CircuitMonkey/mnemosyne/Documents/photos/mnemosyne-pcbs - 1.jpeg

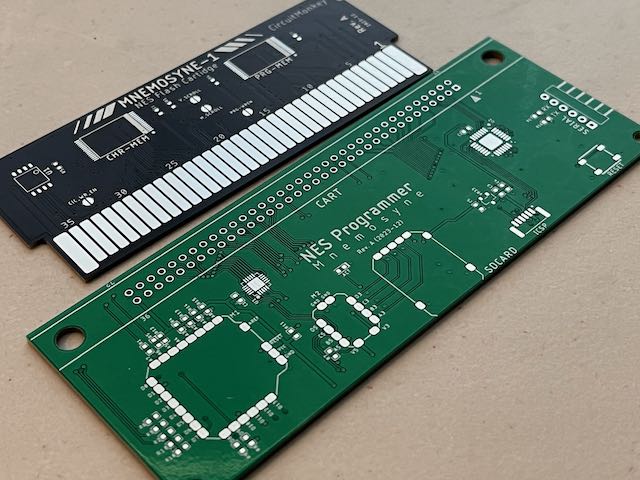
Documents/photos/mnemosyne-pcbs - 1.jpeg
