CircuitMonkey/mnemosyne/README.md

# mnemosyne
Flash based NES Cartridge and programmer. Experimental project.
