CircuitMonkey/mnemosyne/Documents/nes-cartridge-bom.ods

NES Cartridge |  |  | Rev. A (2023-12)
Part | Value | Device | Package | Description | COST01 | COST10 | COST100 | MFR | MPN
PCB1 | NES Min Size | NES-CARTRIDGE-MAX | NES-1-MIN | NES Cartridge
R1 | 10K | RESISTOR0603 | 0603-RES | Resistor | 0.1 | 0.05 | 0.02
R4 | 10K | RESISTOR0603 | 0603-RES | Resistor | 0.1 | 0.05 | 0.02
R5 | 10K | RESISTOR0603 | 0603-RES | Resistor | 0.1 | 0.05 | 0.02
C1 | 0.1uF | CAPACITOR0603 | 0603-CAP | Capacitor | 0.12 | 0.09 | 0.05
C2 | 0.1uF | CAPACITOR0603 | 0603-CAP | Capacitor | 0.12 | 0.09 | 0.05
U1 | ATtiny13A | ATTINY13A-SO8 | SOIC-8S2 | ATmega 13A microcontroller | 1.1 | 1 | 0.8 | Microchip | ATTINY13A-S
CHR-MEM | FLASH 512K x 8 | FLASH_512KX8-512K-TSOP | TSOP32-14X8MM | Flash - 8 bit parallel, up to 512Kx8 | 2.3 | 2.1 | 1.8 | Microchip | SST39SF040-70-4C-Wxx
PRG-MEM | FLASH 512K x 8 | FLASH_512KX8-512K-TSOP | TSOP32-14X8MM | Flash - 8 bit parallel, up to 512Kx8 | 2.3 | 2.1 | 1.8 | Microchip | SST39SF040-70-4C-Wxx
