CircuitMonkey/mnemosyne/Documents/nes-programmer-1-bom.ods

Mnemosyne NES Programmer |  |  | Rev. A (2023-12)
Part | Value | Device | Package | Description | COST01 | COST10 | COST100 | MFR | MPN | MPN2 | MPN3 | SEEED | VALUE
PCB | PCB |  |  | PCB for programmer | $10.00 | $7.00 | $1.00
R1 | 4.7K | RESISTOR0603 | 0603-RES | Resistor | $0.10 | $0.05 | $0.02
R2 | 330 | RESISTOR0603 | 0603-RES | Resistor | $0.10 | $0.05 | $0.02
R3 | 330 | RESISTOR0603 | 0603-RES | Resistor | $0.10 | $0.05 | $0.02
R4 | 4.7K | RESISTOR0603 | 0603-RES | Resistor | $0.10 | $0.05 | $0.02
R5 | 330 | RESISTOR0603 | 0603-RES | Resistor | $0.10 | $0.05 | $0.02
R6 | 330 | RESISTOR0603 | 0603-RES | Resistor | $0.10 | $0.05 | $0.02
R7 | 10K | RESISTOR0603 | 0603-RES | Resistor | $0.10 | $0.05 | $0.02
R8 | 10K | RESISTOR0603 | 0603-RES | Resistor | $0.10 | $0.05 | $0.02
R9 | 10K | RESISTOR0603 | 0603-RES | Resistor | $0.10 | $0.05 | $0.02
R10 | 10K | RESISTOR0603 | 0603-RES | Resistor | $0.10 | $0.05 | $0.02
R11 | 10K | RESISTOR0603 | 0603-RES | Resistor | $0.10 | $0.05 | $0.02
R12 | 10K | RESISTOR0603 | 0603-RES | Resistor | $0.10 | $0.05 | $0.02
R13 | 4.7K | RESISTOR0603 | 0603-RES | Resistor | $0.10 | $0.05 | $0.02
R14 | 4.7K | RESISTOR0603 | 0603-RES | Resistor | $0.10 | $0.05 | $0.02
R15 | 4.7K | RESISTOR0603 | 0603-RES | Resistor | $0.10 | $0.05 | $0.02
R16 | 330 | RESISTOR0603 | 0603-RES | Resistor | $0.10 | $0.05 | $0.02
R17 | 330 | RESISTOR0603 | 0603-RES | Resistor | $0.10 | $0.05 | $0.02
R18 | 2K | RESISTOR0603 | 0603-RES | Resistor | $0.10 | $0.05 | $0.02
C1 | 0.1uF | CAPACITOR0603 | 0603-CAP | Capacitor | $0.12 | $0.09 | $0.05
C2 | 0.1uF | CAPACITOR0603 | 0603-CAP | Capacitor | $0.12 | $0.09 | $0.05
C3 | 0.1uF | CAPACITOR0603 | 0603-CAP | Capacitor | $0.12 | $0.09 | $0.05
C4 | 10uF | CAPACITOR0603 | 0603-CAP | Capacitor | $0.12 | $0.09 | $0.05
C5 | 10uF | CAPACITOR0603 | 0603-CAP | Capacitor | $0.12 | $0.09 | $0.05
ACT | RED | SMT0603 | SMD_0603 | LED SMT | $0.20 | $0.17 | $0.14
U1 | MCP23S08 | MCP23S08-QFN | QFN-20 | Microchip 8-bit SPI I/O Expander | $1.65 | $1.65 | $1.32 | Microchip | MCP23S08-E/ML |  |  |  | MCP23S08
U2 | MCP23S17 | MCP23S17-QFN | QFN-28-6X6 | 16-Bit I/O Expander with SPI | $2.20 | $2.10 | $1.70 | Microchip | MCP23S17-x/ML |  |  |  | MCP23S17
VR33 | 3.3V | LDO-3P--3.3V-SOT23 | SOT-23 | regulator 3-pin | $0.76 | $0.66 | $0.55 |  | AP2120N-3.3 | XC6206P332MR-G | AP7387-33SA | 310030099 | 3.3V
M1 | ATmega328P Module | 0119REV-A | 0119A | ATmega328P Module | $18.38 | $13.22 | $9.09 | Circuit Monkey | 0119A |  |  |  | ATmega328P Module
M2 | 0124A | 0124REV-A | 0124A | Logic Level Translator | $5.17 | $3.60 | $1.86 | Circuit Monkey | 0124A |  |  |  | 0124A
SDCARD | 0127A | 0127REV-A | 0127A | SD Card Micro | $8.23 | $5.24 | $4.02 | Circuit Monkey | 0127A
RESET | Push Switch | PUSHBTN-MOMB3SN | B3SN | Pushbutton Switch | $1.05 | $0.95 | $0.75 | Omron | B3SN |  |  |  | Push Switch
CART | NES Cart Slot | NES-RECEPTACLE-VT-THD | NES-CONNECTOR | Receptacle for NES cartridge | $4.00 | $2.80 | $2.50 | AliExpress | not defined |  |  |  | NES Cart Slot, 72P, VT, THD
SERIAL | Molex 22-28-8062 | CON_06X1-RA | MA06X1-RA-THD | Header, 6-pin, single row | $0.30 | $0.20 | $0.10 |  |  |  |  |  | Molex 22-28-8062
ICSP | Connector, 6P, SM, VT | 06P-SM-VT-SMT | BM06B-SRSS-TB | Connector, 6P | $0.60 | $0.52 | $0.49 | JST | BM06-SRSS-TB |  |  |  | Connector, 6P, SM, VT
