CircuitMonkey/mnemosyne/PCB/nes-programmer-1.brd

## EAGLE design PCB/nes-programmer-1.brd (2024-01-12)

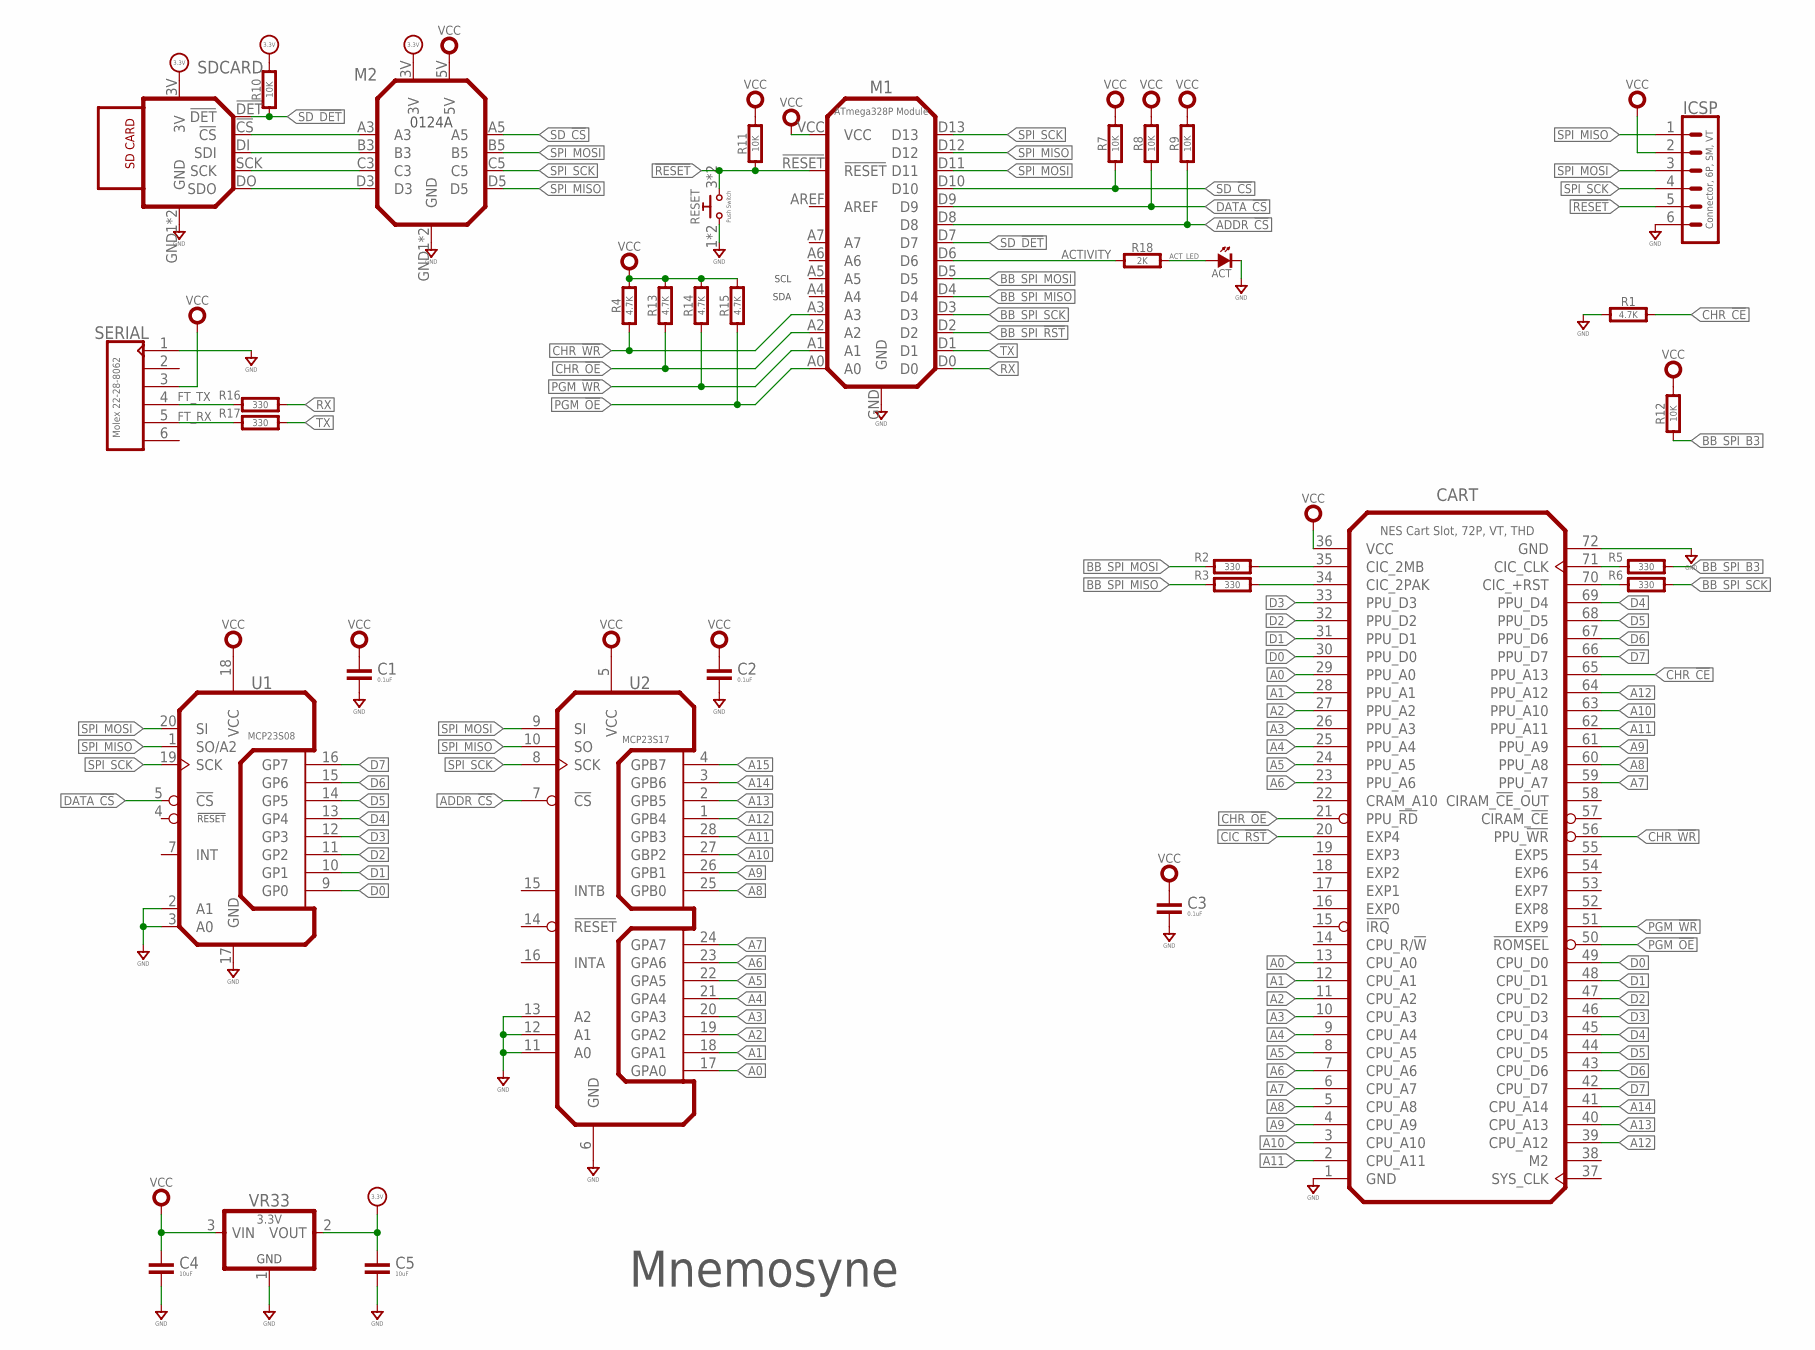
[picture p2: schematic nes-programmer-1.sch]

Parts:
ACT: SMT0603; SMD_0603
C1, C2, C3: 0.1uF; 0603-CAP
C4, C5: 10uF; 0603-CAP
CART: NES Cart Slot, 72P, VT, THD; NES-CONNECTOR-VT-THD
ICSP: Connector, 6P, SM, VT; BM06B-SRSS-TB
M1: ATmega328P Module; 0119A
M2: 0124A
R1, R4, R13, R14, R15: 4.7K; 0603-RES
R2, R3, R5, R6, R16, R17: 330; 0603-RES
R7, R8, R9, R10, R11, R12: 10K; 0603-RES
R18: 2K; 0603-RES
RESET: Push Switch; B3SN
SDCARD: 0127REV-A; 0127A
SERIAL: Molex 22-28-8062; MA06X1-RA-THD
U1: MCP23S08; QFN-20
U2: MCP23S17; QFN-28-6X6
VR33: 3.3V; SOT-23

Connections:
!RESET: ICSP.5, M1.!RESET, R11.1, RESET.3 (2), RESET.4 (2)
+3.3V: C5.1, M2.3V, R10.2, SDCARD.3V, VR33.2 (VOUT)
A0: CART.13 (CPU_A0), CART.29 (PPU_A0), U2.17 (GPA0)
A1: CART.12 (CPU_A1), CART.28 (PPU_A1), U2.18 (GPA1)
A2: CART.11 (CPU_A2), CART.27 (PPU_A2), U2.19 (GPA2)
A3: CART.10 (CPU_A3), CART.26 (PPU_A3), U2.20 (GPA3)
A4: CART.9 (CPU_A4), CART.25 (PPU_A4), U2.21 (GPA4)
A5: CART.8 (CPU_A5), CART.24 (PPU_A5), U2.22 (GPA5)
A6: CART.7 (CPU_A6), CART.23 (PPU_A6), U2.23 (GPA6)
A7: CART.6 (CPU_A7), CART.59 (PPU_A7), U2.24 (GPA7)
A8: CART.5 (CPU_A8), CART.60 (PPU_A8), U2.25 (GPB0)
A9: CART.4 (CPU_A9), CART.61 (PPU_A9), U2.26 (GPB1)
A10: CART.3 (CPU_A10), CART.63 (PPU_A10), U2.27 (GBP2)
A11: CART.2 (CPU_A11), CART.62 (PPU_A11), U2.28 (GPB3)
A12: CART.39 (CPU_A12), CART.64 (PPU_A12), U2.1 (GPB4)
A13: CART.40 (CPU_A13), U2.2 (GPB5)
A14: CART.41 (CPU_A14), U2.3 (GPB6)
A15: U2.4 (GPB7)
ACTIVITY: M1.D6, R18.1
ACT_LED: ACT.A, R18.2
ADDR_!CS: M1.D8, R9.1, U2.7 (!CS)
BB_SPI_!RST: M1.D2
BB_SPI_B3: R5.2, R12.1
BB_SPI_MISO: M1.D4, R3.1
BB_SPI_MOSI: M1.D5, R2.1
BB_SPI_SCK: M1.D3, R6.2
CHR_!CE: CART.65 (PPU_A13), R1.2
CHR_!OE: CART.21 (PPU_!RD), M1.A2, R13.1
CHR_!WR: CART.56 (PPU_!WR), M1.A3, R4.1
CIC_2MB: CART.35 (CIC_2MB), R2.2
CIC_2PAK: CART.34 (CIC_2PAK), R3.2
CIC_!RST: CART.20 (EXP4)
CIC_+RST: CART.70 (CIC_+RST), R6.1
CIC_CLK: CART.71 (CIC_CLK), R5.1
D0: CART.30 (PPU_D0), CART.49 (CPU_D0), U1.9 (GP0)
D1: CART.31 (PPU_D1), CART.48 (CPU_D1), U1.10 (GP1)
D2: CART.32 (PPU_D2), CART.47 (CPU_D2), U1.11 (GP2)
D3: CART.33 (PPU_D3), CART.46 (CPU_D3), U1.12 (GP3)
D4: CART.45 (CPU_D4), CART.69 (PPU_D4), U1.13 (GP4)
D5: CART.44 (CPU_D5), CART.68 (PPU_D5), U1.14 (GP5)
D6: CART.43 (CPU_D6), CART.67 (PPU_D6), U1.15 (GP6)
D7: CART.42 (CPU_D7), CART.66 (PPU_D7), U1.16 (GP7)
DATA_!CS: M1.D9, R8.1, U1.5 (!CS)
FT_RX: R17.1, SERIAL.5
FT_TX: R16.1, SERIAL.4
GND: ACT.K (C), C1.2, C2.2, C3.2, C4.2, C5.2, CART.1 (GND), CART.72 (GND), ICSP.6, M1.GND, M2.GND1 (GND), M2.GND2 (GND), R1.1, RESET.1, RESET.2 (1), SDCARD.GND1 (GND), SDCARD.GND2 (GND), SERIAL.1, U1.2 (A1), U1.3 (A0), U1.17 (GND), U2.6 (GND), U2.11 (A0), U2.12 (A1), U2.13 (A2), VR33.1 (GND)
unnamed: M2.D3, SDCARD.DO (SDO)
unnamed: M2.C3, SDCARD.SCK
unnamed: M2.B3, SDCARD.DI (SDI)
unnamed: M2.A3, SDCARD.!CS
PGM_!OE: CART.50 (!ROMSEL), M1.A0, R15.1
PGM_!WR: CART.51 (EXP9), M1.A1, R14.1
RX: M1.D0, R16.2
SD_!CS: M1.D10, M2.A5, R7.1
SD_!DET: M1.D7, R10.1, SDCARD.!DET
SPI_MISO: ICSP.1, M1.D12, M2.D5, U1.1 (SO/A2), U2.10 (SO)
SPI_MOSI: ICSP.3, M1.D11, M2.B5, U1.20 (SI), U2.9 (SI)
SPI_SCK: ICSP.4, M1.D13, M2.C5, U1.19 (SCK), U2.8 (SCK)
TX: M1.D1, R17.2
VCC: C1.1, C2.1, C3.1, C4.1, CART.36 (VCC), ICSP.2, M1.VCC, M2.5V, R4.2, R7.2, R8.2, R9.2, R11.2, R12.2, R13.2, R14.2, R15.2, SERIAL.3, U1.18 (VCC), U2.5 (VCC), VR33.3 (VIN)

Notes on the sheet:
SDA
SCL
Mnemosyne

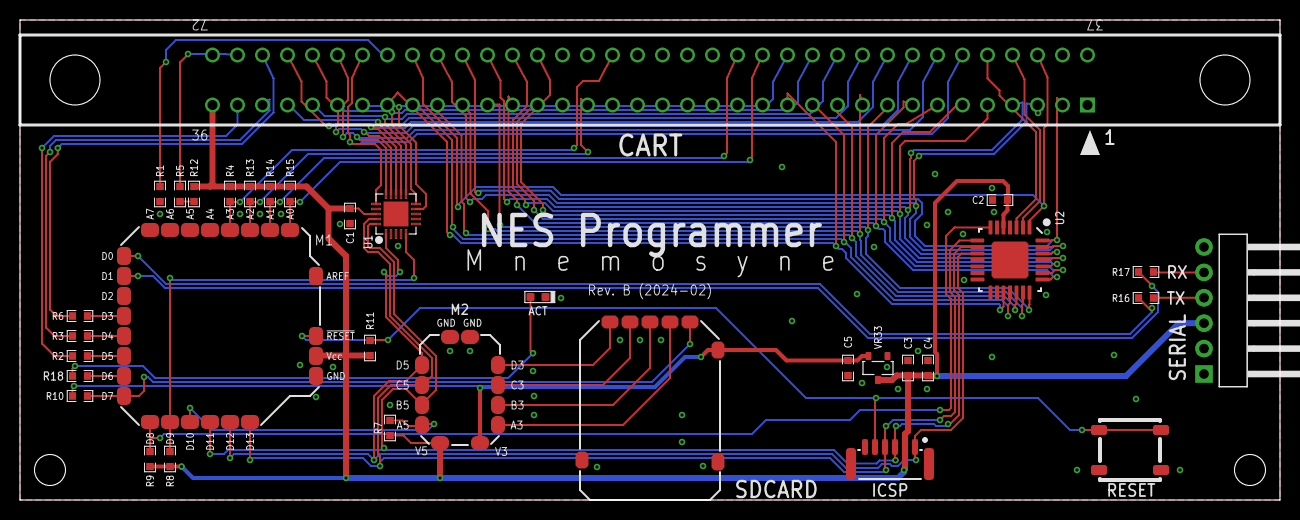
[picture p3: board nes-programmer-1.brd from above]

Board: 2 copper layers, 126.0 x 48.0 mm, 34 parts (0 on the bottom side), 57 nets.
