CircuitMonkey/mnemosyne/PCB/nes-cartridge.brd

## EAGLE design PCB/nes-cartridge.brd (2023-12-23)

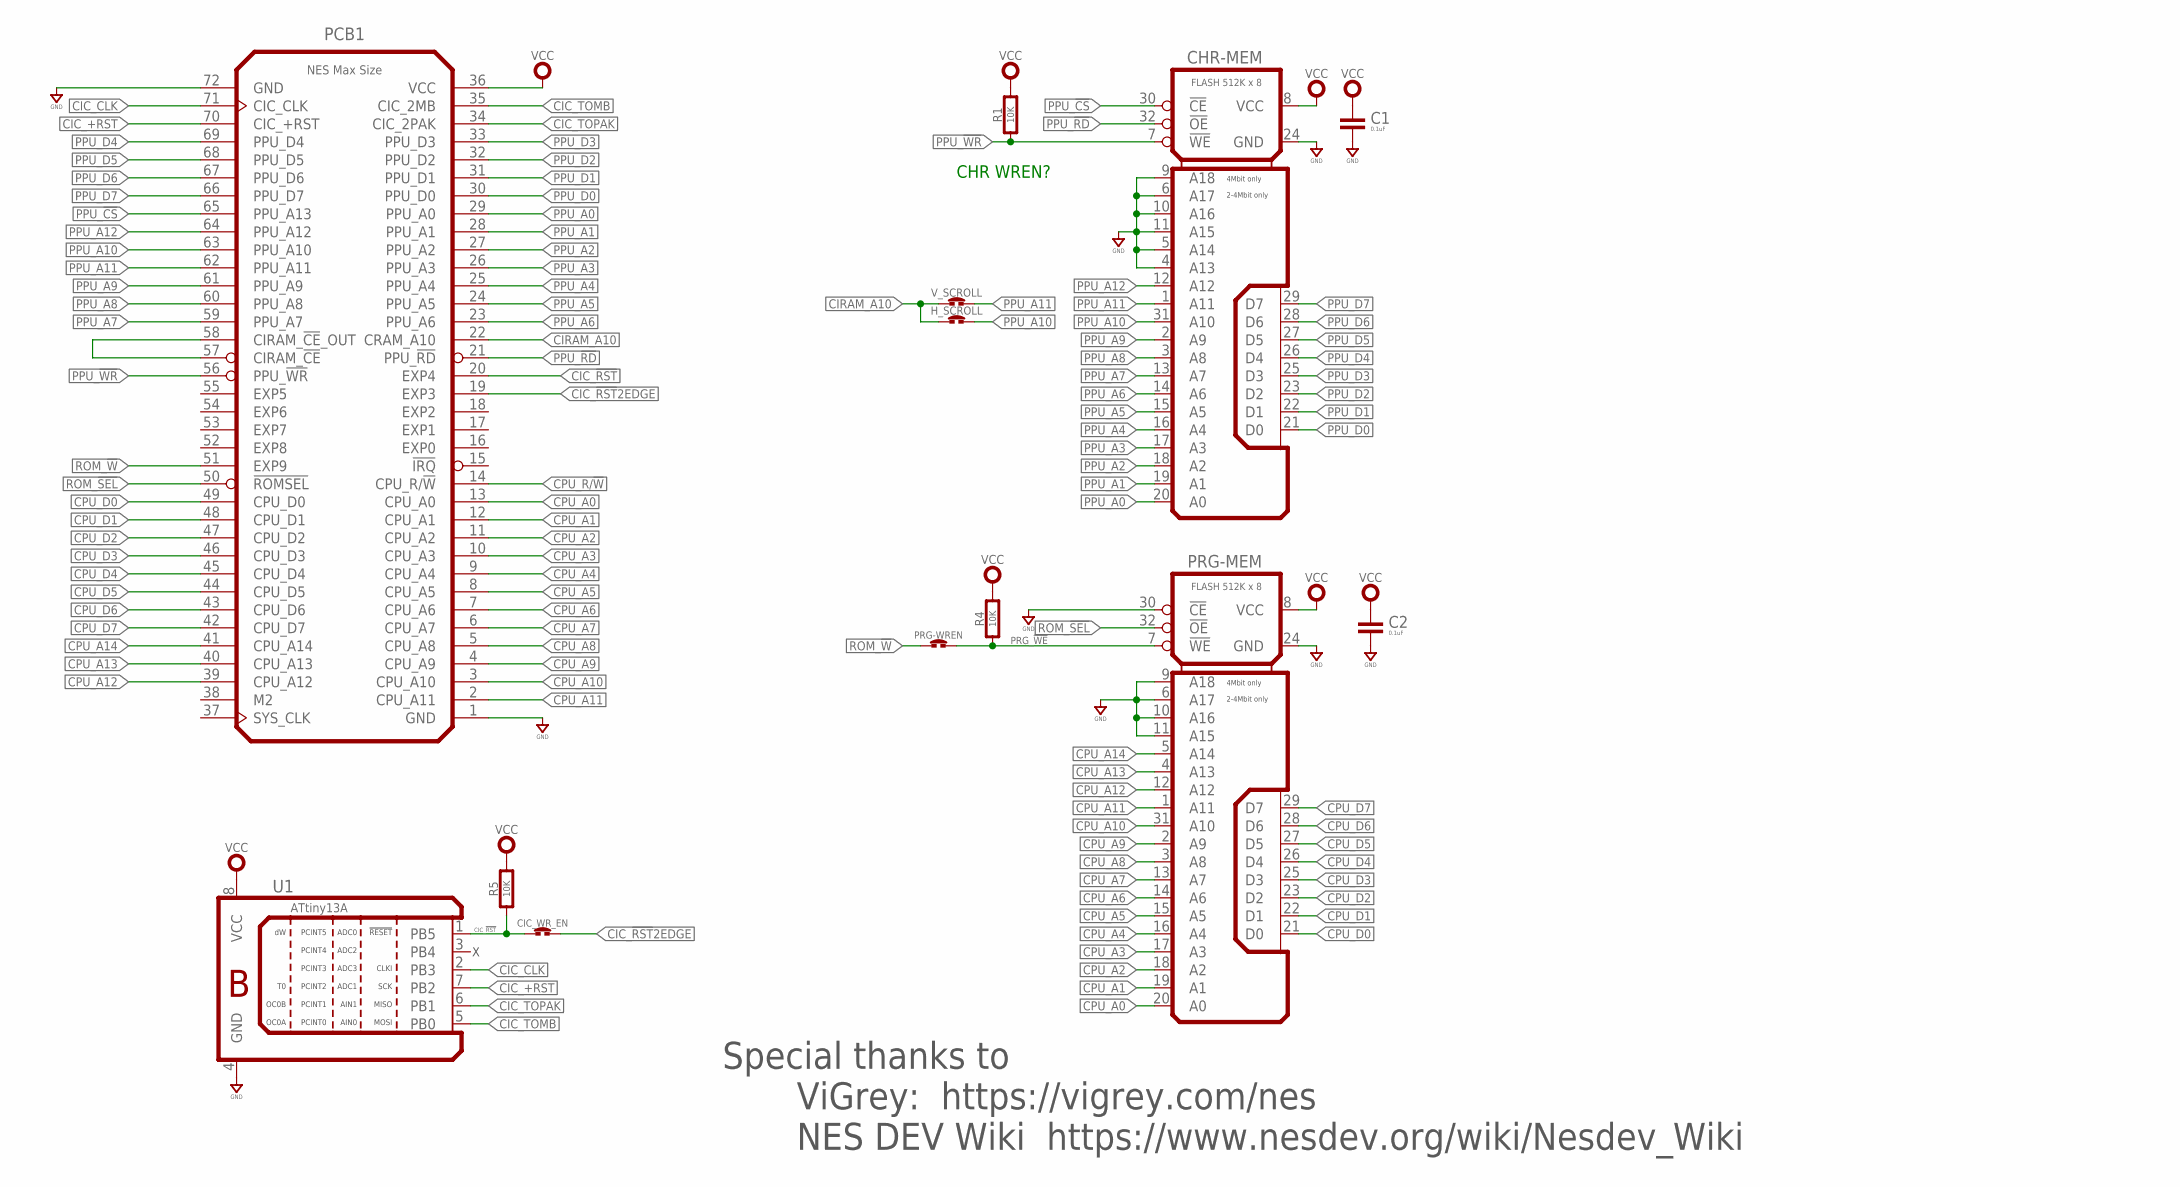
[picture p4: schematic nes-cartridge.sch]

Parts:
C1, C2: 0.1uF; 0603-CAP
CHR-MEM: FLASH 512K x 8; TSOP32-14X8MM
CIC_WR_EN: SOLDER_JUMPER-80MIL-RND; SOLDER_JUMP_80MIL_RND
H_SCROLL: SOLDER_JUMPER-80MIL-RND; SOLDER_JUMP_80MIL_RND
PCB1: NES Max Size; NES-1-MIN
PRG-MEM: FLASH 512K x 8; TSOP32-14X8MM
PRG-WREN: SOLDER_JUMPER-80MIL-RND; SOLDER_JUMP_80MIL_RND
R1, R4, R5: 10K; 0603-RES
U1: ATtiny13A; SOIC-8S2
V_SCROLL: SOLDER_JUMPER-80MIL-RND; SOLDER_JUMP_80MIL_RND

Connections:
CIC_!RST: CIC_WR_EN.1, PCB1.20 (EXP4), R5.1, U1.1 (PB5)
CIC_!RST!2EDGE: CIC_WR_EN.2, PCB1.19 (EXP3)
CIC_+RST: PCB1.70 (CIC_+RST), U1.7 (PB2)
CIC_CLK: PCB1.71 (CIC_CLK), U1.2 (PB3)
CIC_TOMB: PCB1.35 (CIC_2MB), U1.5 (PB0)
CIC_TOPAK: PCB1.34 (CIC_2PAK), U1.6 (PB1)
CIRAM_A10: H_SCROLL.1, PCB1.22 (CRAM_A10), V_SCROLL.1
CPU_A0: PCB1.13 (CPU_A0), PRG-MEM.20 (A0)
CPU_A1: PCB1.12 (CPU_A1), PRG-MEM.19 (A1)
CPU_A2: PCB1.11 (CPU_A2), PRG-MEM.18 (A2)
CPU_A3: PCB1.10 (CPU_A3), PRG-MEM.17 (A3)
CPU_A4: PCB1.9 (CPU_A4), PRG-MEM.16 (A4)
CPU_A5: PCB1.8 (CPU_A5), PRG-MEM.15 (A5)
CPU_A6: PCB1.7 (CPU_A6), PRG-MEM.14 (A6)
CPU_A7: PCB1.6 (CPU_A7), PRG-MEM.13 (A7)
CPU_A8: PCB1.5 (CPU_A8), PRG-MEM.3 (A8)
CPU_A9: PCB1.4 (CPU_A9), PRG-MEM.2 (A9)
CPU_A10: PCB1.3 (CPU_A10), PRG-MEM.31 (A10)
CPU_A11: PCB1.2 (CPU_A11), PRG-MEM.1 (A11)
CPU_A12: PCB1.39 (CPU_A12), PRG-MEM.12 (A12)
CPU_A13: PCB1.40 (CPU_A13), PRG-MEM.4 (A13)
CPU_A14: PCB1.41 (CPU_A14), PRG-MEM.5 (A14)
CPU_D0: PCB1.49 (CPU_D0), PRG-MEM.21 (D0)
CPU_D1: PCB1.48 (CPU_D1), PRG-MEM.22 (D1)
CPU_D2: PCB1.47 (CPU_D2), PRG-MEM.23 (D2)
CPU_D3: PCB1.46 (CPU_D3), PRG-MEM.25 (D3)
CPU_D4: PCB1.45 (CPU_D4), PRG-MEM.26 (D4)
CPU_D5: PCB1.44 (CPU_D5), PRG-MEM.27 (D5)
CPU_D6: PCB1.43 (CPU_D6), PRG-MEM.28 (D6)
CPU_D7: PCB1.42 (CPU_D7), PRG-MEM.29 (D7)
CPU_R/!W: PCB1.14 (CPU_R/!W)
GND: C1.2, C2.2, CHR-MEM.4 (A13), CHR-MEM.5 (A14), CHR-MEM.6 (A17), CHR-MEM.9 (A18), CHR-MEM.10 (A16), CHR-MEM.11 (A15), CHR-MEM.24 (GND), PCB1.1 (GND), PCB1.72 (GND), PRG-MEM.6 (A17), PRG-MEM.9 (A18), PRG-MEM.10 (A16), PRG-MEM.11 (A15), PRG-MEM.24 (GND), U1.4 (GND)
unnamed: PCB1.57 (CIRAM_!CE), PCB1.58 (CIRAM_!CE!_OUT)
PPU_!CS: CHR-MEM.30 (!CE), PCB1.65 (PPU_A13)
PPU_!RD: CHR-MEM.32 (!OE), PCB1.21 (PPU_!RD)
PPU_!WR: CHR-MEM.7 (!WE), PCB1.56 (PPU_!WR), R1.1
PPU_A0: CHR-MEM.20 (A0), PCB1.29 (PPU_A0)
PPU_A1: CHR-MEM.19 (A1), PCB1.28 (PPU_A1)
PPU_A2: CHR-MEM.18 (A2), PCB1.27 (PPU_A2)
PPU_A3: CHR-MEM.17 (A3), PCB1.26 (PPU_A3)
PPU_A4: CHR-MEM.16 (A4), PCB1.25 (PPU_A4)
PPU_A5: CHR-MEM.15 (A5), PCB1.24 (PPU_A5)
PPU_A6: CHR-MEM.14 (A6), PCB1.23 (PPU_A6)
PPU_A7: CHR-MEM.13 (A7), PCB1.59 (PPU_A7)
PPU_A8: CHR-MEM.3 (A8), PCB1.60 (PPU_A8)
PPU_A9: CHR-MEM.2 (A9), PCB1.61 (PPU_A9)
PPU_A10: CHR-MEM.31 (A10), H_SCROLL.2, PCB1.63 (PPU_A10)
PPU_A11: CHR-MEM.1 (A11), PCB1.62 (PPU_A11), V_SCROLL.2
PPU_A12: CHR-MEM.12 (A12), PCB1.64 (PPU_A12)
PPU_D0: CHR-MEM.21 (D0), PCB1.30 (PPU_D0)
PPU_D1: CHR-MEM.22 (D1), PCB1.31 (PPU_D1)
PPU_D2: CHR-MEM.23 (D2), PCB1.32 (PPU_D2)
PPU_D3: CHR-MEM.25 (D3), PCB1.33 (PPU_D3)
PPU_D4: CHR-MEM.26 (D4), PCB1.69 (PPU_D4)
PPU_D5: CHR-MEM.27 (D5), PCB1.68 (PPU_D5)
PPU_D6: CHR-MEM.28 (D6), PCB1.67 (PPU_D6)
PPU_D7: CHR-MEM.29 (D7), PCB1.66 (PPU_D7)
PRG_!WE: PRG-MEM.7 (!WE), PRG-WREN.2, R4.1
ROM_!SEL: PCB1.50 (!ROMSEL), PRG-MEM.32 (!OE)
ROM_!W: PCB1.51 (EXP9), PRG-WREN.1
VCC: C1.1, C2.1, CHR-MEM.8 (VCC), PCB1.36 (VCC), PRG-MEM.8 (VCC), R1.2, R4.2, R5.2, U1.8 (VCC)

Notes on the sheet:
Special thanks to ViGrey: https://vigrey.com/nes NES DEV Wiki https://www.nesdev.org/wiki/Nesdev_Wiki
CHR WREN?

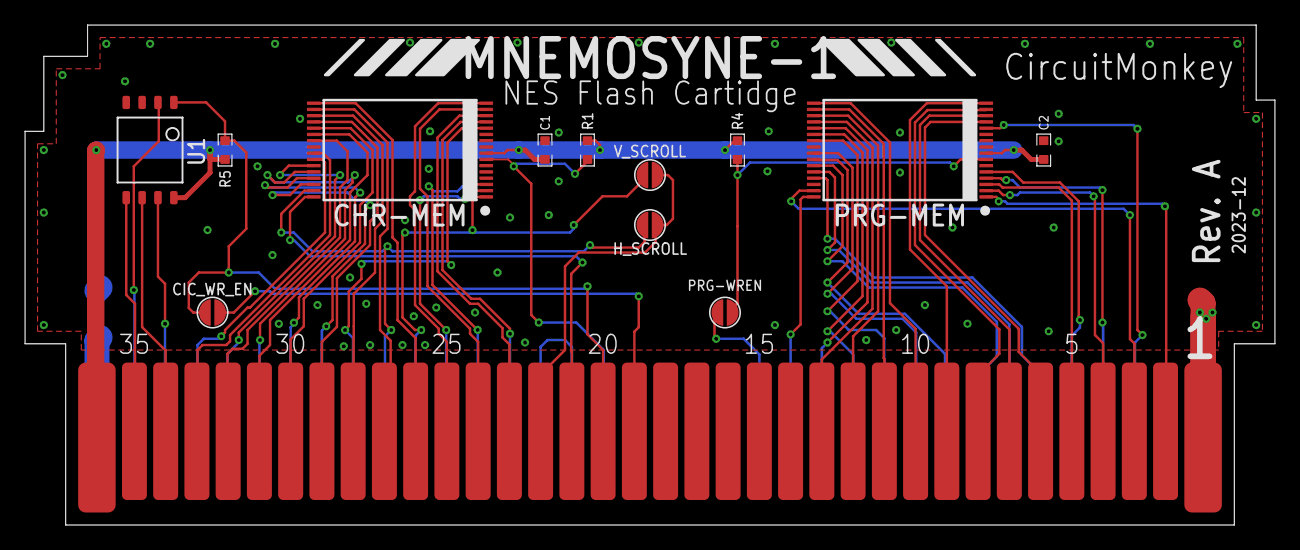
[picture p5: board nes-cartridge.brd from above]

Board: 2 copper layers, 100.0 x 40.0 mm, 13 parts (0 on the bottom side), 60 nets.
