CircuitMonkey/mnemosyne/(commit log)

2023-12-02 First upload
    [nes-cartridge.brd, nes-cartridge.sch]
2023-12-06 Cart board and programmer board checkpoint.
    [nes-cartridge.brd, nes-cartridge.sch, nes-programmer-1.brd, nes-programmer-1.sch]
2023-12-23 Final tweaks.
    [nes-cartridge.brd, nes-programmer-1.brd, nes-programmer-1.sch]
2023-12-23 PCBs as FABed in 12-2023
2024-01-12 Added Cap values, bump rev due to PCB change.
    [nes-programmer-1.sch]
2024-01-12 Bump rev to B. Fix connector hole spacing issue.
    [nes-programmer-1.brd]
2024-01-12 Creat BOMs
    [nes-cartridge-bom.ods, nes-cartridge.sch, nes-programmer-1-bom.ods]
